audiyofan/jx12-project/schematics/psu.png

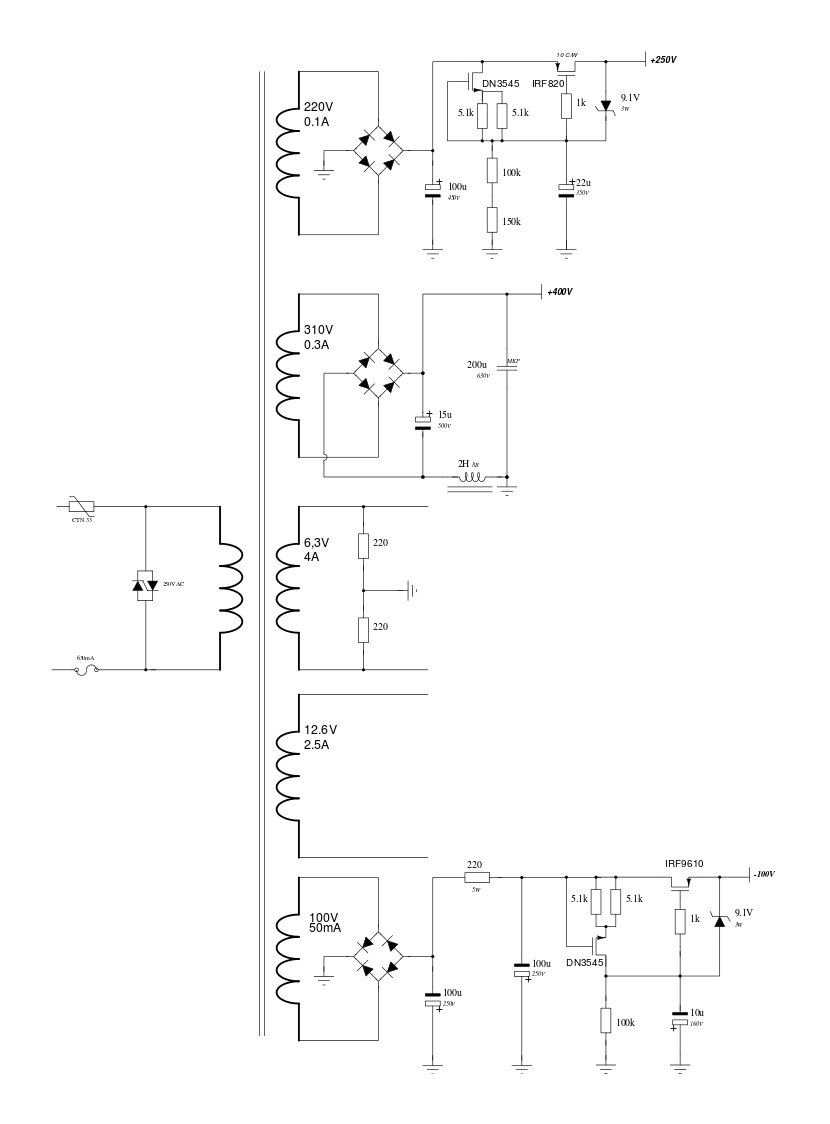
schematics/psu.png
