audiyofan/jx12-project/schematics/bom.md

# BILL OF MATERIALS

## Amplifier

 Got  Nr  Description
 [X]  4×  capacitor, 47nF, 250V MKP
 [X]  2×  capacitor, 100nF, 250V MKP
 [ ]  2×  capacitor, 200pF, 250V ceramic
 [ ]  4×  capacitor, 100pF, 63V ceramic
 [ ]  2×  capacitor, 270pF, 63V ceramic
 [X]  8×  resistor, 470K
 [ ]  2×  resistor, 100K, 1%, 0.5W
 [ ]  4×  resistor, 220K, 1%, 0.5W
 [ ]  4×  resistor, 12K, 1%, 1W
 [ ]  4×  potentiometer lin 2k
 [ ]  2×  potentiometer log 47k
 [ ]  2×  resistor, 22K, 1%, 2W
 [ ]  4×  resistor, 10K
 [X]  2×  resistor, 1M
 [ ]  2×  resistor, 410, 1%, 0.5W

## Power supply

 Got  Nr  Description
 [X]  1×  diode bridge 450V 16A
 [X]  1×  diode bridge 250V 8A
 [X]  4×  resistor, 220
 [ ]  1×  resistor, 270, 3W
 [X]  1×  capacitor, 220u, 250V
 [X]  2×  zener diode, 40V 5W
 [X]  1×  zener diode, 30V 5W
 [X]  1×  capacitor, 1u, 250V MKP
 [X]  1×  capacitor, 470u, 350V
 [X]  1×  resistor, 10k
 [X]  1×  resistor, 100k
 [X]  1×  zener diode, 200V, 5W
 [X]  1×  zener diode, 50V, 5W
 [X]  1×  resistor, 1k
 [X]  1×  capacitor, 15u, 350V
 [X]  1×  mosfet IRF820
 [X]  1×  heatsink 15°C/W TO220
