audiyofan/jx12-project/(commit log)

2013-05-06 BOM and last version.
2013-05-08 Added volume pots to the BOM.
2013-06-11 Correction filters are now ok
2013-06-17 Reduced HT capacitor to 100uF.
2013-06-18 6AQ5 grid stopper to 10kΩ.
2013-07-07 Added 230V psu, 220n coupling.
2013-07-10 Smaller schematic.
2013-08-05 Switched back 6N2P PSU to 250V.
2013-12-16 Added 1Ω R in 6AQ5's cathods
2014-02-24 Simpler schematic (Vins version)
    Simpler +250 PSU
    Replaced 1.3W Zener by 3W in PSU
    Showed 6N16B load as 2×47kΩ in anode and 2×820Ω in cathod
2014-04-21 Model 400 schematic
2016-10-10 change driver for 6N1P-EV
